someguy131/ShakerTable-V2/BOM-revised.xlsx

Item | Link | Cost | Amount | Total Item | Grand Total
2020 Extrusion | https://www.amazon.com/Fumive-T-Slot-Aluminum-Extrusion-Printer/dp/B0CPS3J7FB?sp_csd=d2lkZ2V0TmFtZT1zcF9hdGY | $24.99 | 1 | $24.99 | $186.38
V Slot Roller Plates | https://www.amazon.com/Aluminum-Extrusion-Eccentric-Spacer-Replacement/dp/B0986PYTNJ | $9.99 | 2 | $19.98
Belt Drive Materials | https://www.amazon.com/Zeelo-Timing-Pulley-Meters-Printer/dp/B08SMFM3Z6 | $16.99 | 1 | $16.99
NEMA 17 Stepper | https://www.amazon.com/Stepper-57x57x113mm-Stepping-23HS2430B-Engraving/dp/B0CQLJJ2K2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 | $26.99 | 1 | $26.99
Arduino | https://www.amazon.com/ELEGOO-Board-ATmega328P-ATMEGA16U2-Compliant/dp/B01EWOE0UU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 | $16.99 | 1 | $16.99
S-360-24 Power Supply | https://www.amazon.com/S-360-24-Switch-Transformer-Supply-Switching/dp/B0DFB84KWL | $22.50 | 1 | $22.50
PETG Fillament - gray 2 pack | https://us.store.bambulab.com/products/petg-basic?variant=41184283852936 | $27.99 | 1 | $27.99
Stepper motor driver | https://www.amazon.com/gp/product/B07HHS14VQ/ref=ox_sc_saved_title_4?smid=A1RTFVCI20VZT2&th=1 | $9.98 | 1 | $9.98
Power supply cable | https://www.amazon.com/Pinfox-Universal-Appliance-Replacement-Pigtail/dp/B06XQZFD36 | $12.99 | 1 | $12.99
Jumper Wires | https://www.amazon.com/Elegoo-EL-CP-004-Multicolored-Breadboard-arduino/dp/B01EV70C78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 | $6.98 | 1 | $6.98
 |  |  |  | $0.00
 |  |  |  | $0.00
 |  |  |  | $0.00
 |  |  |  | $0.00
 |  |  |  | $0.00
 |  |  |  | $0.00
 |  |  |  | $0.00
 |  |  |  | $0.00
 |  |  |  | $0.00
 |  |  |  | $0.00
 |  |  |  | $0.00
 |  |  |  | $0.00
 |  |  |  | $0.00
 |  |  |  | $0.00
 |  |  |  | $0.00
 |  |  |  | $0.00
 |  |  |  | $0.00
 |  |  |  | $0.00
 |  |  |  | $0.00
 |  |  |  | $0.00
 |  |  |  | $0.00
 |  |  |  | $0.00
