someguy131/ShakerTable-V2/(commit log)

2026-02-27 Add files via upload
    This version reworks the square wave control to be functional with the TB6600 driver, as trapezoidal control.
2026-05-31 Upload run table, Revised BOM
    Uploaded a complete run table in excel format. Added BOM (revised to reflect materials actually present in shaker table)
    [BOM-revised.xlsx, Shaker-data-complete.xlsx]
2026-05-31 Fixed upload of wrong BOM file
    [BOM-revised.xlsx]
